chamatt/Arduino-LED-Voice-Control/README.md

# Arduino-LED-Voice-Control
Controlling a house mockup ilumination from android with voice commands and arduino.
