chamatt/Arduino-LED-Voice-Control/Circuits/Bluetooth Module.png

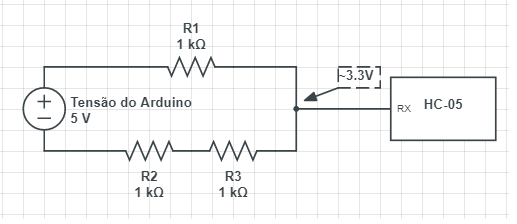
Circuits/Bluetooth Module.png
