chamatt/Arduino-LED-Voice-Control/Circuits/Diagrama de Comando.png

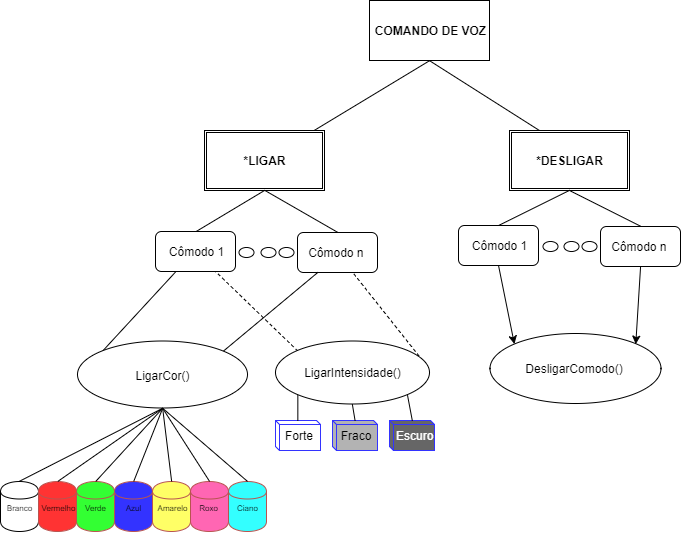
Circuits/Diagrama de Comando.png
