chamatt/Arduino-LED-Voice-Control/Circuits/RGB LEDs.png

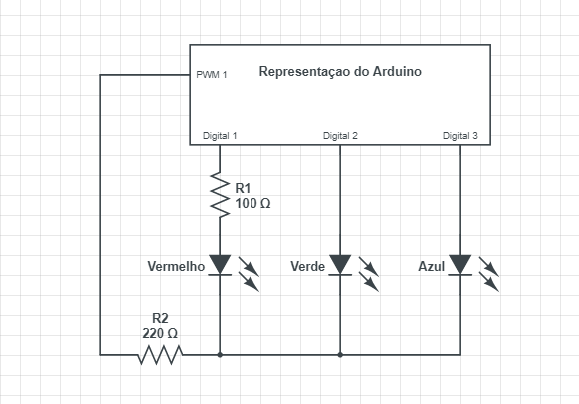
Circuits/RGB LEDs.png
