chamatt/Arduino-LED-Voice-Control/(list of files, drawings)

Other design files:
Circuits/PCB Prototype.DSN
Circuits/PCB Prototype.LYT
