chamatt/Arduino-LED-Voice-Control/(commit log)

2017-07-22 Basic Functions Implemented
    *I decided to put this on GitHub half-way through, so this commit is quite a big leap. *
    This is a non-woking state, no pins are set.
    Functions Implemented:
    - Receives chars from arduino bluetooth module and puts words on a String array.
    - Ligar() - runs functions to treats the input and stores it in variables and fire the LigarCor() method to turn on the LED with it's respective colors.
    - ObtemCor() - Gets the color.
    - ObtemPinos() - Gets the R, G and B pins from the LED that's going to be turned on.
    - LigarCor() - Turns on the LED(s) with the required color.
2017-07-22 Some ajustments
    - Uncommented some stuff.
    - Added white color
    - Fixed Headers
    [androidvoice.ino]
2017-07-23 Fixed RGB LED implementation and Added Switch Buttons
    The RGB LED on this project are common anode, this means that the power source will come from a PWM output, and we are going to use the digital OUTPUT in current sinking mode.
    This means that i had to:
    - Swapp HIGH - LOW digital OUTPUT signals. LOW now means it's gonna turn ON, and HIGH means it's gonna turn OFF.
    - Add the PWM ports.
    Also added the ports i, in particular, am gonna use in this project. Later i'll probably realease the house plant and the PCB that goes with the project.
    Last thing i did was add the switch buttons.
    They work like this:
    - Turns ON white if LED is turned OFF.
    - Turns OFF if any single LED (be it R, G or B,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
    [androidvoice.ino]
2017-07-24 Fixed A LOT OF STUFF
    - It was actually common Cathode, not Anode, so i had to switch all the Highs and Lows.
    - I also forgot to add the PWMs pins.
    - Added tons of debugging Serial println's.
    - Fixed a lot of minor bugs.
    [androidvoice.ino]
2017-07-29 Another bunch of fixed stuff - working version
    Fixed lot's of stuff by testing it and seeing what was going wrong. Swapped a lot of pins in the code to match the real life prototype and made a lot of other small changes. Schematics for the full project, to be printed in a PCB included, and circuits within explained.
    [PCB Prototype.DSN, PCB Prototype.LYT]
